ThorbenH/BarbelMotionTracker/3D-Files/Lid.stl

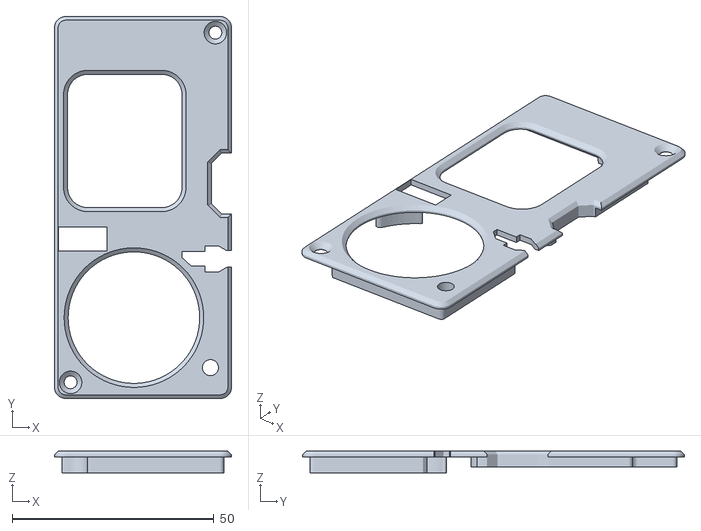
[picture p1: CAD file, 2024-10-22]
3D-Files/Lid.stl
43.9 x 94.7 x 5.40
