ThorbenH/BarbelMotionTracker/3D-Files/ScreenBackSupport.stl

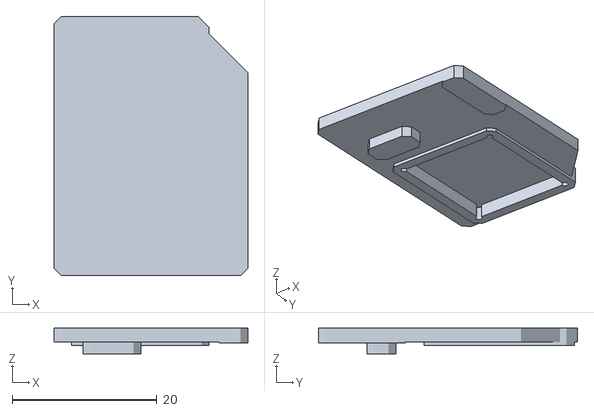
[picture p2: CAD file, 2024-10-22]
3D-Files/ScreenBackSupport.stl
26.8 x 35.8 x 3.55
