ThorbenH/BarbelMotionTracker/3D-Files/Case.stl

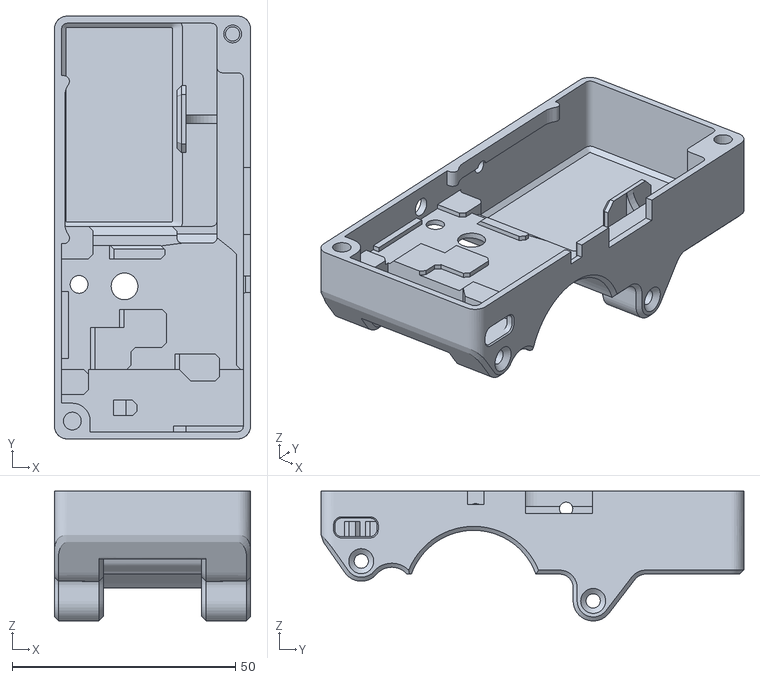
[picture p3: CAD file, 2024-10-22]
3D-Files/Case.stl
43.9 x 94.7 x 29.1
