ThorbenH/BarbelMotionTracker/3D-Files/EncoderSpacer.stl

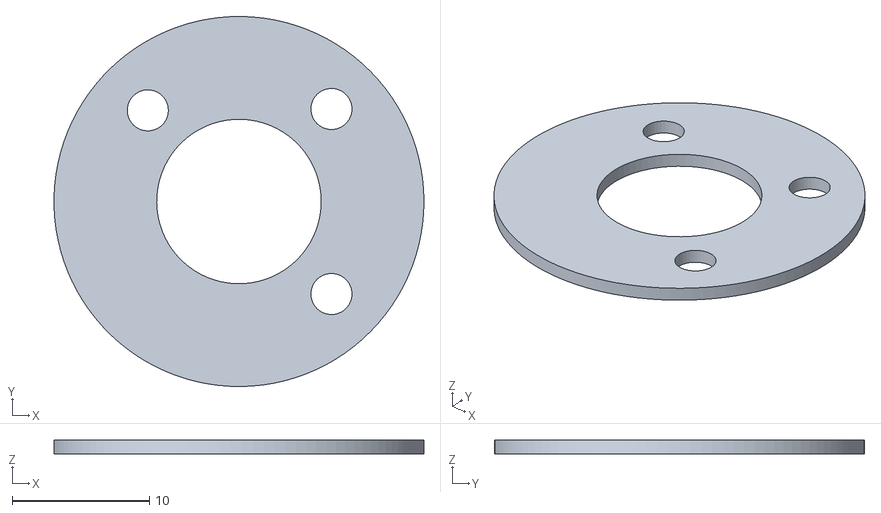
[picture p4: CAD file, 2024-10-22]
3D-Files/EncoderSpacer.stl
27.0 x 27.0 x 1.00
