ThorbenH/BarbelMotionTracker/3D-Files/LidClosedSD.stl

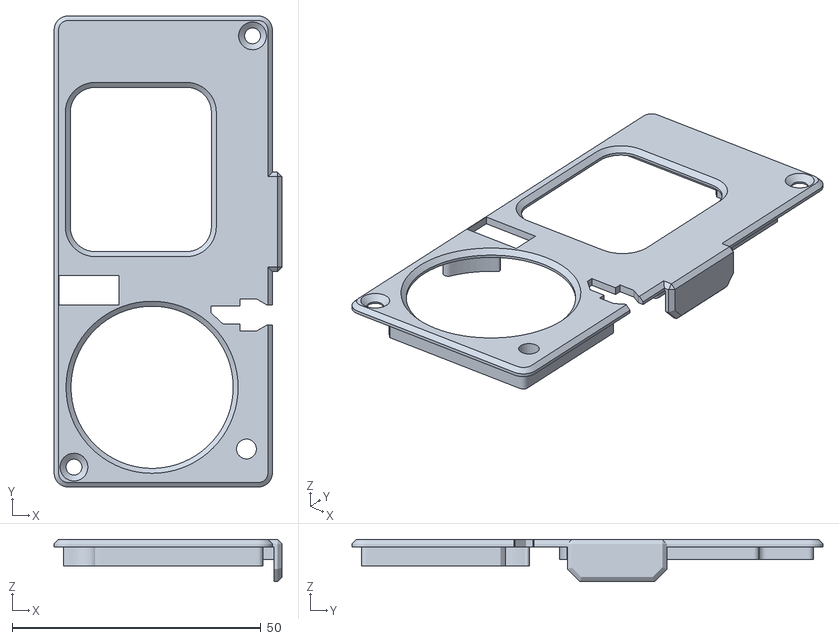
[picture p5: CAD file, 2024-10-22]
3D-Files/LidClosedSD.stl
45.8 x 94.7 x 8.50
