ThorbenH/BarbelMotionTracker/PCB_Design/BarbelMotionTracker-V1.kicad_pcb

## KiCad design PCB_Design/BarbelMotionTracker-V1.kicad_pcb (2024-09-08)

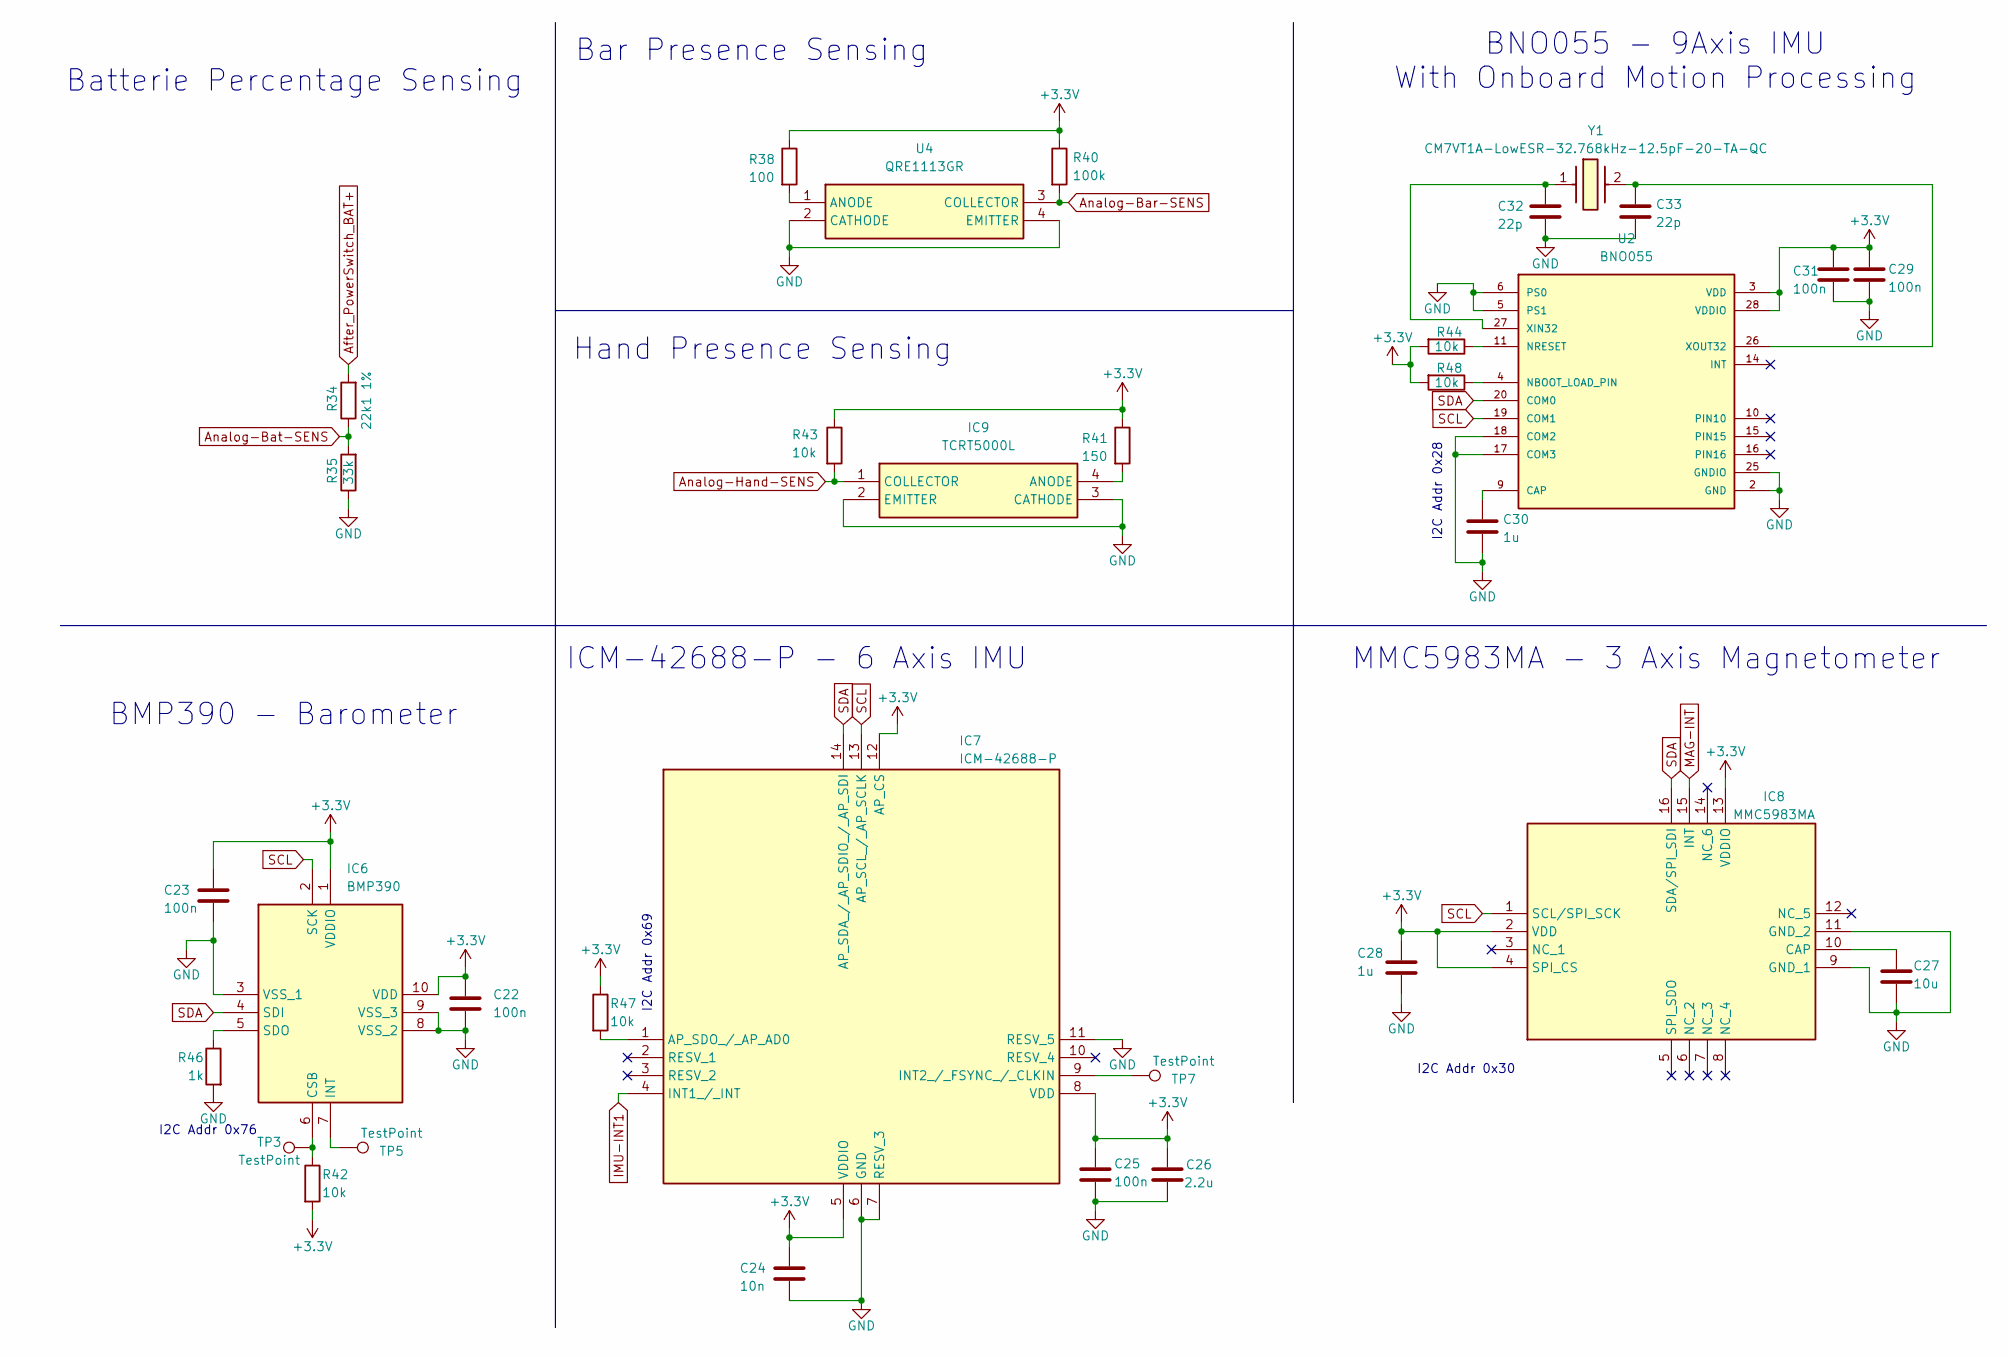
[picture p6: schematic sensors.kicad_sch, Barbel Motion Tracker]

Parts:
C22, C23, C25, C29, C31: 100n; C_0603_1608Metric
C24: 10n; C_0603_1608Metric
C26: 2.2u; C_0603_1608Metric
C27: 10u; C_0805_2012Metric
C28, C30: 1u; C_0603_1608Metric
C32, C33: 22p; C_0402_1005Metric
IC6: BMP390; Mouser Part Number 262-BMP390
IC7: ICM-42688-P; IIM42352; Mouser Part Number 410-ICM-42688-P
IC8: MMC5983MA; Mouser Part Number 438-MMC5983MA
IC9: TCRT5000L; Mouser Part Number 782-TCRT5000L
R34: 22k1 1%; R_0603_1608Metric
R35: 33k; R_0603_1608Metric
R38: 100; R_1206_3216Metric
R40: 100k; R_0603_1608Metric
R41: 150; R_1206_3216Metric
R42, R43, R44, R47, R48: 10k; R_0603_1608Metric
R46: 1k; R_0603_1608Metric
TP3, TP5, TP7: TestPoint; TestPoint_Pad_D1.0mm
U2: BNO055; LGA28R50P4X10_380X520X100
U4: QRE1113GR; Mouser Part Number 512-QRE1113GR
Y1: CM7VT1A-LowESR-32.768kHz-12.5pF-20-TA-QC; CM7V32768TBQA020; Mouser Part Number 428-202740-MG01

Connections:
+3.3V: C22.1, C23.1, C24.1, C25.1, C26.1, C28.1, C29.1, C31.1, IC6.1 (VDDIO), IC6.10 (VDD), IC7.5 (VDDIO), IC7.8 (VDD), IC7.12 (AP_CS), IC8.2 (VDD), IC8.4 (SPI_CS), IC8.13 (VDDIO), R38.1, R40.1, R41.1, R42.2, R43.1, R44.2, R47.1, R48.2, U2.3 (VDD), U2.28 (VDDIO); also elsewhere on the board
After_PowerSwitch_BAT+: R34.2; also elsewhere on the board
Analog-Bar-SENS: R40.2, U4.3 (COLLECTOR); also elsewhere on the board
Analog-Bat-SENS: R34.1, R35.2; also elsewhere on the board
Analog-Hand-SENS: IC9.1 (COLLECTOR), R43.2; also elsewhere on the board
GND: C22.2, C23.2, C24.2, C25.2, C26.2, C27.2, C28.2, C29.2, C30.2, C31.2, C32.2, C33.2, IC6.3 (VSS_1), IC6.8 (VSS_2), IC6.9 (VSS_3), IC7.6 (GND), IC7.7 (RESV_3), IC7.11 (RESV_5), IC8.9 (GND_1), IC8.11 (GND_2), IC9.2 (EMITTER), IC9.3 (CATHODE), R35.1, R46.2, U2.2 (GND), U2.5 (PS1), U2.6 (PS0), U2.17 (COM3), U2.18 (COM2), U2.25 (GNDIO), U4.2 (CATHODE), U4.4 (EMITTER); also elsewhere on the board
IMU-INT1: IC7.4 (INT1_/_INT); also elsewhere on the board
MAG-INT: IC8.15 (INT); also elsewhere on the board
unnamed: IC6.6 (CSB), R42.1, TP3.1
unnamed: IC6.7 (INT), TP5.1
unnamed: IC6.5 (SDO), R46.1
unnamed: IC7.1 (AP_SDO_/_AP_AD0), R47.2
unnamed: IC7.9 (INT2_/_FSYNC_/_CLKIN), TP7.1
unnamed: C27.1, IC8.10 (CAP)
unnamed: IC9.4 (ANODE), R41.2
unnamed: C30.1, U2.9 (CAP)
unnamed: R48.1, U2.4 (NBOOT_LOAD_PIN)
unnamed: R44.1, U2.11 (NRESET)
unnamed: C32.1, U2.27 (XIN32), Y1.1
unnamed: C33.1, U2.26 (XOUT32), Y1.2
unnamed: R38.2, U4.1 (ANODE)
SCL: IC6.2 (SCK), IC7.13 (AP_SCL_/_AP_SCLK), IC8.1 (SCL/SPI_SCK), U2.19 (COM1); also elsewhere on the board
SDA: IC6.4 (SDI), IC7.14 (AP_SDA_/_AP_SDIO_/_AP_SDI), IC8.16 (SDA/SPI_SDI), U2.20 (COM0); also elsewhere on the board

Notes on the sheet:
BMP390 - Barometer
I2C Addr 0x28
Batterie Percentage Sensing
ICM-42688-P - 6 Axis IMU
BNO055 - 9Axis IMU With Onboard Motion Processing
MMC5983MA - 3 Axis Magnetometer
Hand Presence Sensing
I2C Addr 0x69
I2C Addr 0x76
Bar Presence Sensing
I2C Addr 0x30

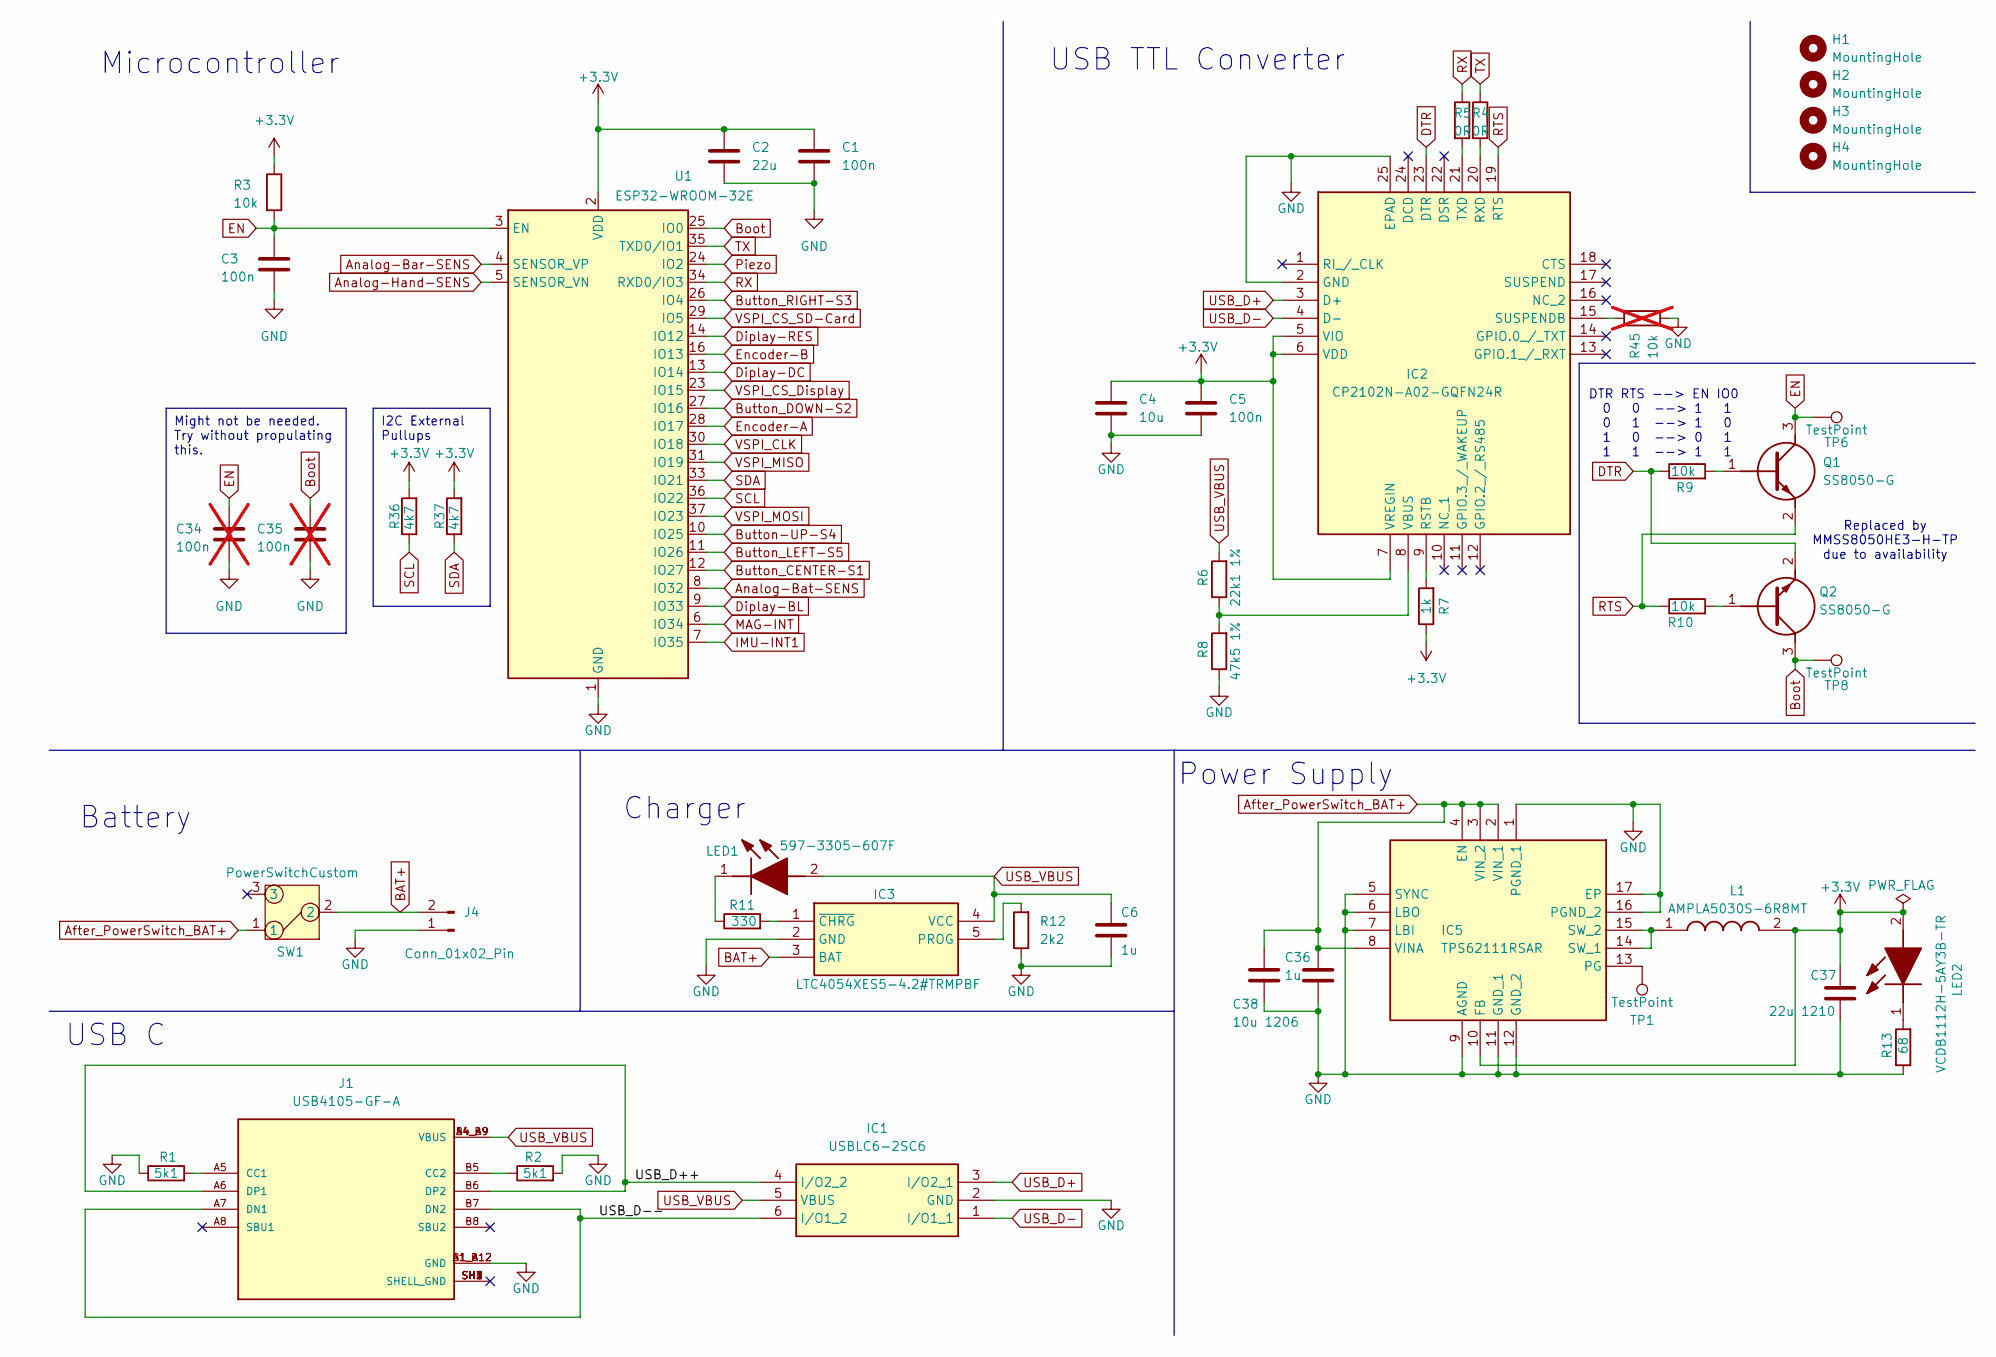
[picture p7: schematic microcontroller.kicad_sch, Barbel Motion Tracker]

Parts:
C1, C3, C5: 100n; C_0603_1608Metric
C2: 22u; C_0805_2012Metric
C4: 10u; C_0805_2012Metric
C6, C36: 1u; C_0603_1608Metric
C34, C35: 100n; C_0603_1608Metric; not fitted
C37: 22u 1210; C_1210_3225Metric
C38: 10u 1206; C_1206_3216Metric
H1, H2, H3, H4: MountingHole; MountingHole_2.2mm_M2
IC1: USBLC6-2SC6; SOT95P280X145-6N; Mouser Part Number 511-USBLC6-2SC6
IC2: CP2102N-A02-GQFN24R; QFN50P400X400X80-25N-D; Mouser Part Number 634-CP2102NA02QFN24R
IC3: LTC4054XES5-4.2#TRMPBF; SOT95P280X100-5N; Mouser Part Number 584-C4054XES54.2TMPF
IC5: TPS62111RSAR; QFN65P400X400X100-17N; Mouser Part Number 595-TPS62111RSAR
J1: USB4105-GF-A; GCT_USB4105-GF-A; PARTREV B3
J4: Conn_01x02_Pin; JST_PH_S2B-PH-K_1x02_P2.00mm_Horizontal
L1: AMPLA5030S-6R8MT; INDPM5752X300N; Manufacturer_Part_Number AMPLA5030S-6R8MT
LED1: 597-3305-607F; LEDC2012X70N; Mouser Part Number 645-597-3305-607F
LED2: VCDB1112H-5AY3B-TR; LEDC2012X90N; Mouser Part Number 327-VCDB1112H5AY3BTR
Q1, Q2: SS8050-G; SOT95P240X115-3N; Mouser Part Number 750-SS8050-G
R1, R2: 5k1; R_0603_1608Metric
R3, R9, R10: 10k; R_0603_1608Metric
R4, R5: 0R; R_0603_1608Metric
R6: 22k1 1%; R_0603_1608Metric
R7: 1k; R_0603_1608Metric
R8: 47k5 1%; R_0603_1608Metric
R11: 330; R_0603_1608Metric
R12: 2k2; R_0603_1608Metric
R13: 68; R_0603_1608Metric
R36, R37: 4k7; R_0603_1608Metric
R45: 10k; R_0603_1608Metric; not fitted
SW1: PowerSwitchCustom
TP1, TP6, TP8: TestPoint; TestPoint_Pad_D1.0mm
U1: ESP32-WROOM-32E

Connections:
+3.3V: C1.1, C2.1, C4.1, C5.1, C37.1, IC2.5 (VIO), IC2.6 (VDD), IC2.7 (VREGIN), IC5.10 (FB), L1.2, LED2.2 (A), R3.1, R7.1, R36.2, R37.2, U1.2 (VDD); also elsewhere on the board
/microcontroller/USB_D++: IC1.4 (I/O2_2), J1.A6 (DP1), J1.B6 (DP2)
/microcontroller/USB_D--: IC1.6 (I/O1_2), J1.A7 (DN1), J1.B7 (DN2)
After_PowerSwitch_BAT+: C36.1, C38.1, IC5.2 (VIN_1), IC5.3 (VIN_2), IC5.4 (EN), IC5.8 (VINA), SW1.1; also elsewhere on the board
Analog-Bar-SENS: U1.4 (SENSOR_VP); also elsewhere on the board
Analog-Bat-SENS: U1.8 (IO32); also elsewhere on the board
Analog-Hand-SENS: U1.5 (SENSOR_VN); also elsewhere on the board
BAT+: IC3.3 (BAT), J4.2, SW1.2
Boot: C35.1, Q2.3 (C), TP8.1, U1.25 (IO0)
Button-UP-S4: U1.10 (IO25); also elsewhere on the board
Button_CENTER-S1: U1.12 (IO27); also elsewhere on the board
Button_DOWN-S2: U1.27 (IO16); also elsewhere on the board
Button_LEFT-S5: U1.11 (IO26); also elsewhere on the board
Button_RIGHT-S3: U1.26 (IO4); also elsewhere on the board
DTR: IC2.23 (DTR), Q2.2 (E), R9.1
Diplay-BL: U1.9 (IO33); also elsewhere on the board
Diplay-DC: U1.13 (IO14); also elsewhere on the board
Diplay-RES: U1.14 (IO12); also elsewhere on the board
EN: C3.1, C34.1, Q1.3 (C), R3.2, TP6.1, U1.3 (EN)
Encoder-A: U1.28 (IO17); also elsewhere on the board
Encoder-B: U1.16 (IO13); also elsewhere on the board
GND: C1.2, C2.2, C3.2, C4.2, C5.2, C6.2, C34.2, C35.2, C36.2, C37.2, C38.2, IC1.2 (GND), IC2.2 (GND), IC2.25 (EPAD), IC3.2 (GND), IC5.1 (PGND_1), IC5.5 (SYNC), IC5.6 (LBO), IC5.7 (LBI), IC5.9 (AGND), IC5.11 (GND_1), IC5.12 (GND_2), IC5.16 (PGND_2), IC5.17 (EP), J1.A1_B12 (GND), J1.B1_A12 (GND), J4.1, R1.1, R2.2, R8.1, R12.1, R13.1, R45.2, U1.1 (GND), U1.15 (GND), U1.38 (GND), U1.39 (GND); also elsewhere on the board
IMU-INT1: U1.7 (IO35); also elsewhere on the board
MAG-INT: U1.6 (IO34); also elsewhere on the board
unnamed: IC2.9 (RSTB), R7.2
unnamed: IC2.20 (RXD), R4.2
unnamed: IC2.15 (SUSPENDB), R45.1
unnamed: IC2.21 (TXD), R5.2
unnamed: IC2.8 (VBUS), R6.1, R8.2
unnamed: IC3.5 (PROG), R12.2
unnamed: IC3.1 (~CHRG), R11.2
unnamed: IC5.13 (PG), TP1.1
unnamed: IC5.14 (SW_1), IC5.15 (SW_2), L1.1
unnamed: J1.A5 (CC1), R1.2
unnamed: J1.B5 (CC2), R2.1
unnamed: LED1.1 (K), R11.1
unnamed: LED2.1 (K), R13.2
unnamed: Q1.1 (B), R9.2
unnamed: Q2.1 (B), R10.2
Piezo: U1.24 (IO2); also elsewhere on the board
RTS: IC2.19 (RTS), Q1.2 (E), R10.1
RX: R5.1, U1.34 (RXD0/IO3)
SCL: R36.1, U1.36 (IO22); also elsewhere on the board
SDA: R37.1, U1.33 (IO21); also elsewhere on the board
TX: R4.1, U1.35 (TXD0/IO1)
USB_D+: IC1.3 (I/O2_1), IC2.3 (D+)
USB_D-: IC1.1 (I/O1_1), IC2.4 (D-)
USB_VBUS: C6.1, IC1.5 (VBUS), IC3.4 (VCC), J1.A4_B9 (VBUS), J1.B4_A9 (VBUS), LED1.2 (A), R6.2
VSPI_CLK: U1.30 (IO18); also elsewhere on the board
VSPI_CS_Display: U1.23 (IO15); also elsewhere on the board
VSPI_CS_SD-Card: U1.29 (IO5); also elsewhere on the board
VSPI_MISO: U1.31 (IO19); also elsewhere on the board
VSPI_MOSI: U1.37 (IO23); also elsewhere on the board

Notes on the sheet:
I2C External Pullups
Might not be needed. Try without propulating this.
DTR RTS --> EN IO0 0 0 --> 1 1 0 1 --> 1 0 1 0 --> 0 1 1 1 --> 1 1
USB C
Charger
USB TTL Converter
Replaced by MMSS8050HE3-H-TP due to availability
Battery
Microcontroller
Power Supply

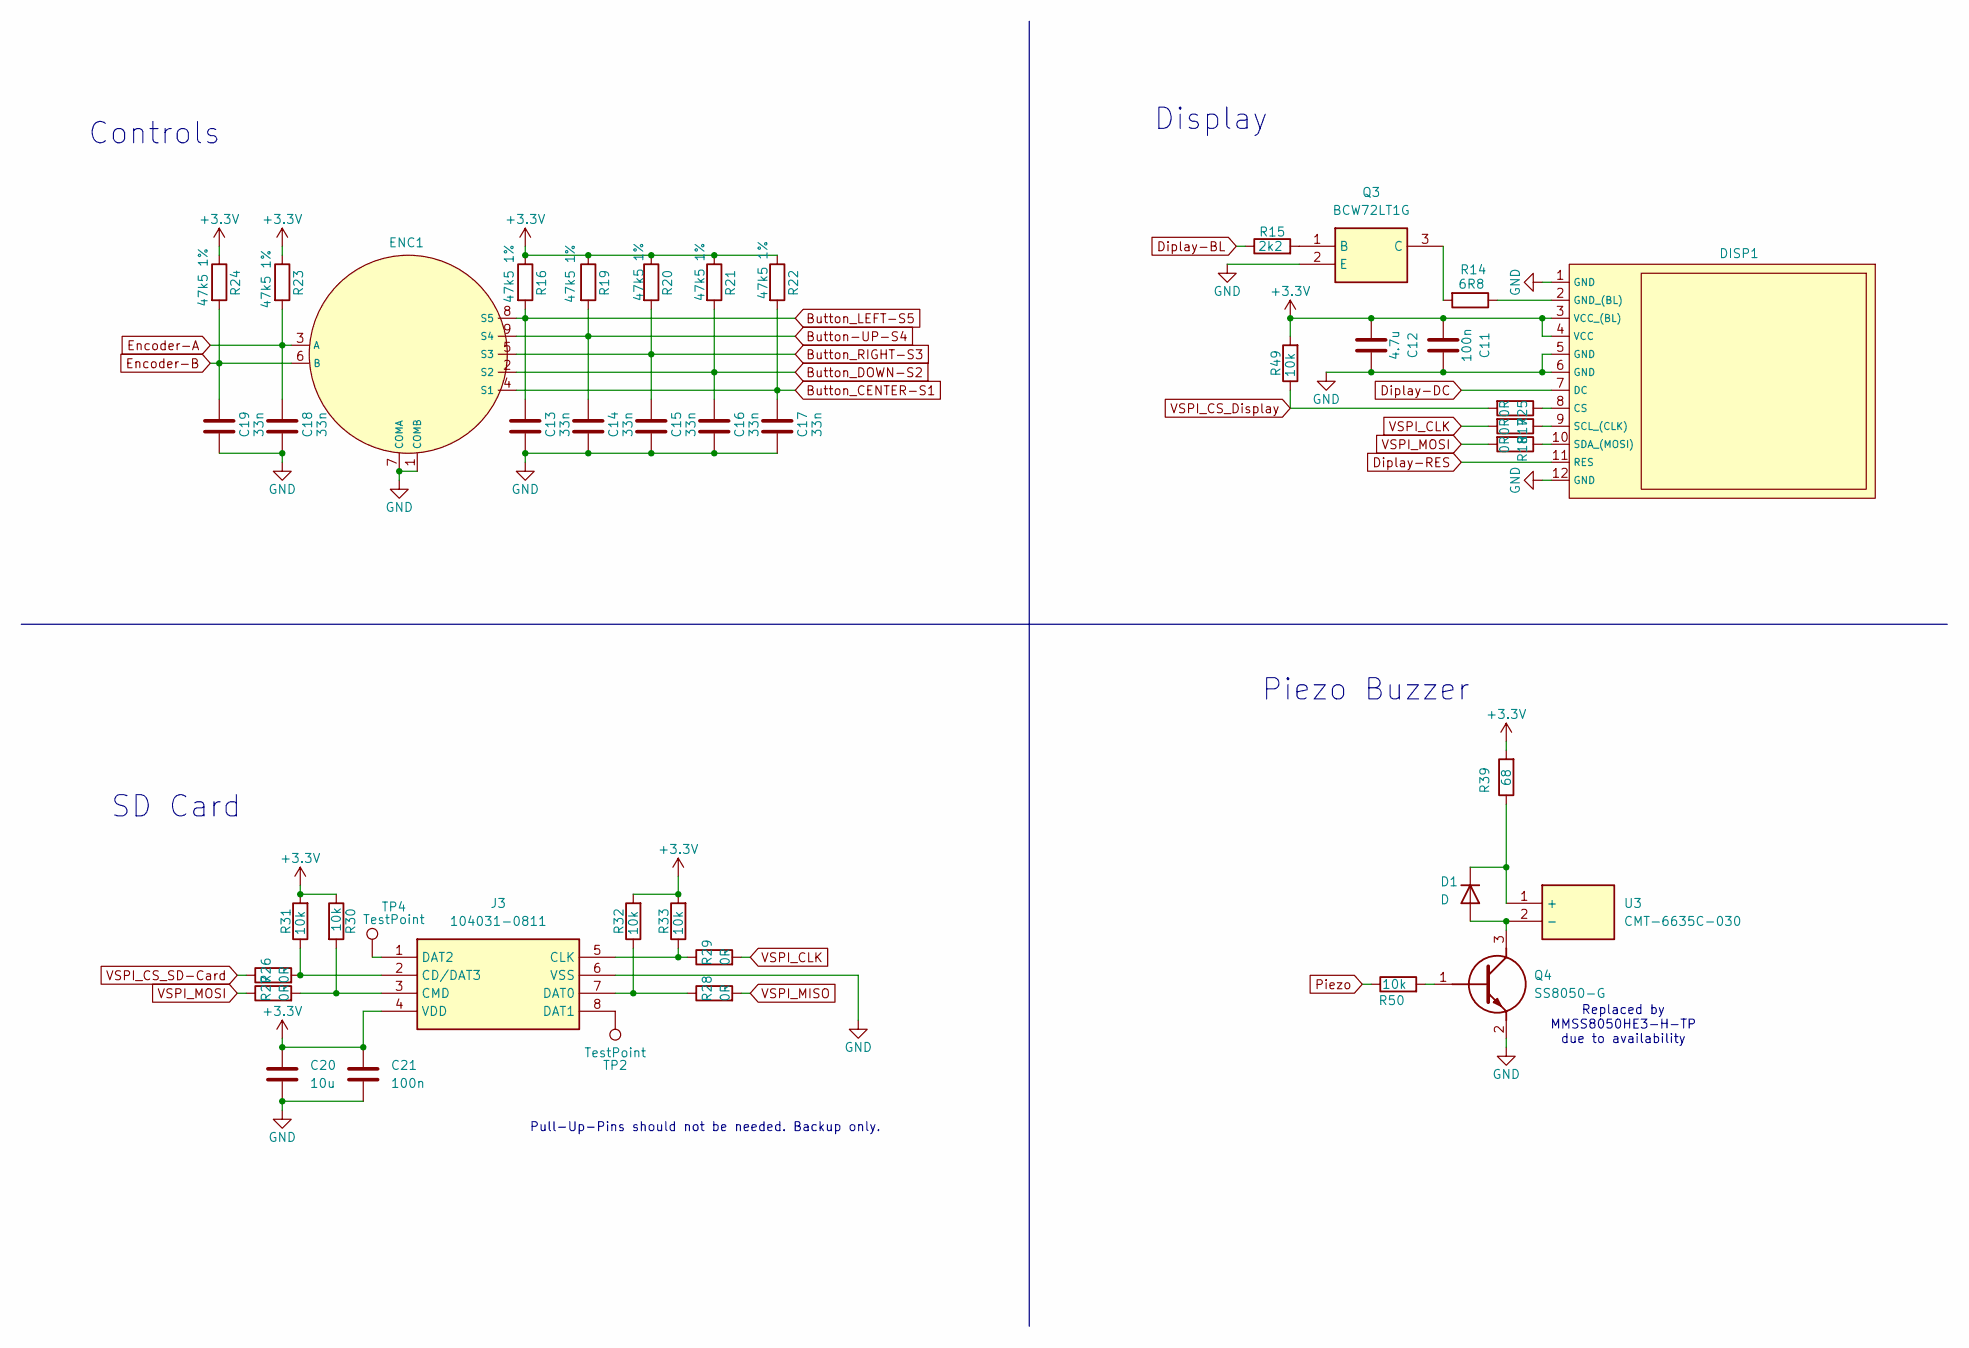
[picture p8: schematic display_control_sdcard.kicad_sch, Barbel Motion Tracker]

Parts:
C11, C21: 100n; C_0603_1608Metric
C12: 4.7u; C_0603_1608Metric
C13, C14, C15, C16, C17, C18, C19: 33n; C_0603_1608Metric
C20: 10u; C_0805_2012Metric
D1: D; D_0805_2012Metric
DISP1: Display_ST7789V2
ENC1: ZippyRotaryEncoder_ANO
J3: 104031-0811; 1040310811; Mouser Part Number 538-104031-0811
Q3: BCW72LT1G; SOT96P237X111-3N; Mouser Part Number 863-BCW72LT1G
Q4: SS8050-G; SOT95P240X115-3N; Mouser Part Number 750-SS8050-G
R14: 6R8; R_1206_3216Metric
R15: 2k2; R_0603_1608Metric
R16, R19, R20, R21, R22, R23, R24: 47k5 1%; R_0603_1608Metric
R17, R18, R25, R26, R27, R28, R29: 0R; R_0603_1608Metric
R30, R31, R32, R33, R49, R50: 10k; R_0603_1608Metric
R39: 68; R_0603_1608Metric
TP2, TP4: TestPoint; TestPoint_Pad_D1.0mm
U3: CMT-6635C-030; CMT6635C030; Mouser Part Number 490-CMT-6635C-030

Connections:
+3.3V: C11.1, C12.1, C20.1, C21.1, DISP1.3 (VCC_(BL)), DISP1.4 (VCC), J3.4 (VDD), R16.1, R19.1, R20.1, R21.1, R22.1, R23.1, R24.1, R30.1, R31.2, R32.2, R33.2, R39.2, R49.2; also elsewhere on the board
Button-UP-S4: C14.2, ENC1.9 (S4), R19.2; also elsewhere on the board
Button_CENTER-S1: C17.2, ENC1.4 (S1), R22.2; also elsewhere on the board
Button_DOWN-S2: C16.2, ENC1.2 (S2), R21.2; also elsewhere on the board
Button_LEFT-S5: C13.2, ENC1.8 (S5), R16.2; also elsewhere on the board
Button_RIGHT-S3: C15.2, ENC1.5 (S3), R20.2; also elsewhere on the board
Diplay-BL: R15.1; also elsewhere on the board
Diplay-DC: DISP1.7 (DC); also elsewhere on the board
Diplay-RES: DISP1.11 (RES); also elsewhere on the board
Encoder-A: C18.2, ENC1.3 (A), R23.2; also elsewhere on the board
Encoder-B: C19.2, ENC1.6 (B), R24.2; also elsewhere on the board
GND: C11.2, C12.2, C13.1, C14.1, C15.1, C16.1, C17.1, C18.1, C19.1, C20.2, C21.2, DISP1.1 (GND), DISP1.5 (GND), DISP1.6 (GND), DISP1.12 (GND), ENC1.1 (COMB), ENC1.7 (COMA), J3.6 (VSS), Q3.2 (E), Q4.2 (E); also elsewhere on the board
unnamed: D1.2 (A), Q4.3 (C), U3.2 (-)
unnamed: D1.1 (K), R39.1, U3.1 (+)
unnamed: DISP1.8 (CS), R25.1
unnamed: DISP1.2 (GND_(BL)), R14.1
unnamed: DISP1.9 (SCL_(CLK)), R17.1
unnamed: DISP1.10 (SDA_(MOSI)), R18.1
unnamed: J3.2 (CD/DAT3), R26.2, R31.1
unnamed: J3.5 (CLK), R29.1, R33.1
unnamed: J3.3 (CMD), R27.2, R30.2
unnamed: J3.7 (DAT0), R28.1, R32.1
unnamed: J3.8 (DAT1), TP2.1
unnamed: J3.1 (DAT2), TP4.1
unnamed: Q3.1 (B), R15.2
unnamed: Q3.3 (C), R14.2
unnamed: Q4.1 (B), R50.2
Piezo: R50.1; also elsewhere on the board
VSPI_CLK: R17.2, R29.2; also elsewhere on the board
VSPI_CS_Display: R25.2, R49.1; also elsewhere on the board
VSPI_CS_SD-Card: R26.1; also elsewhere on the board
VSPI_MISO: R28.2; also elsewhere on the board
VSPI_MOSI: R18.2, R27.1; also elsewhere on the board

Notes on the sheet:
Pull-Up-Pins should not be needed. Backup only.
Piezo Buzzer
Display
Controls
SD Card
Replaced by MMSS8050HE3-H-TP due to availability

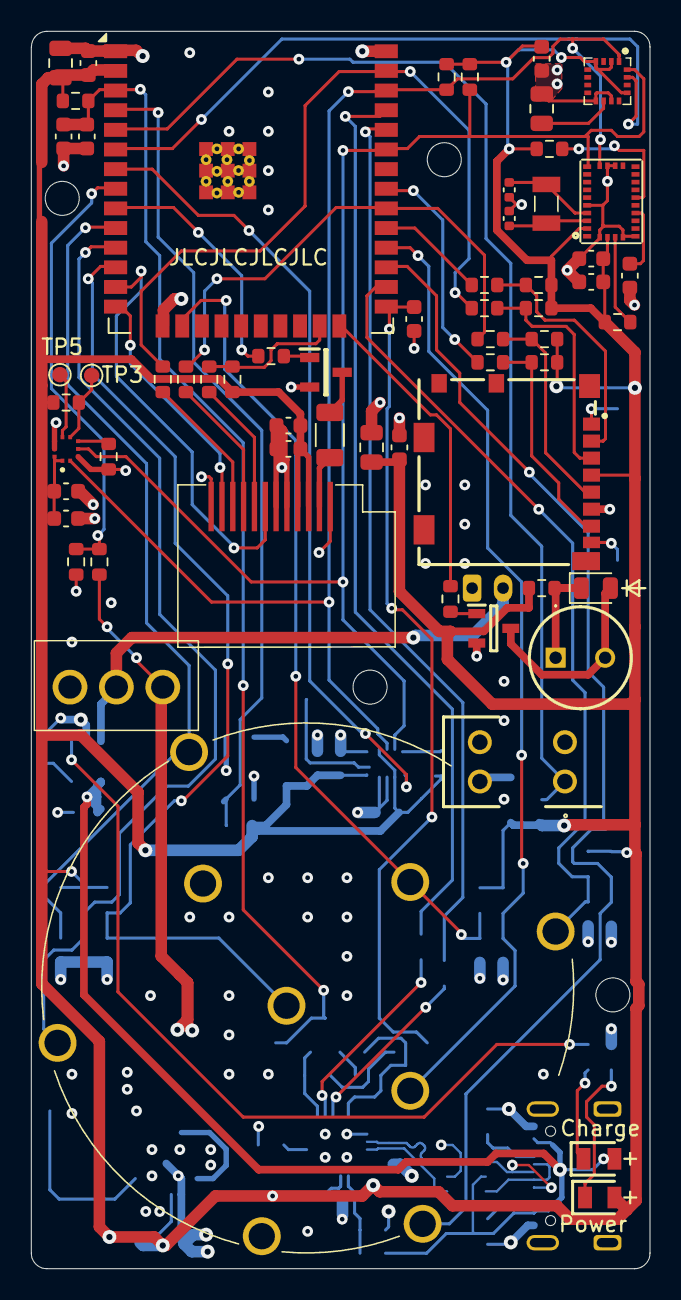
[picture p9: board BarbelMotionTracker-V1.kicad_pcb from above]

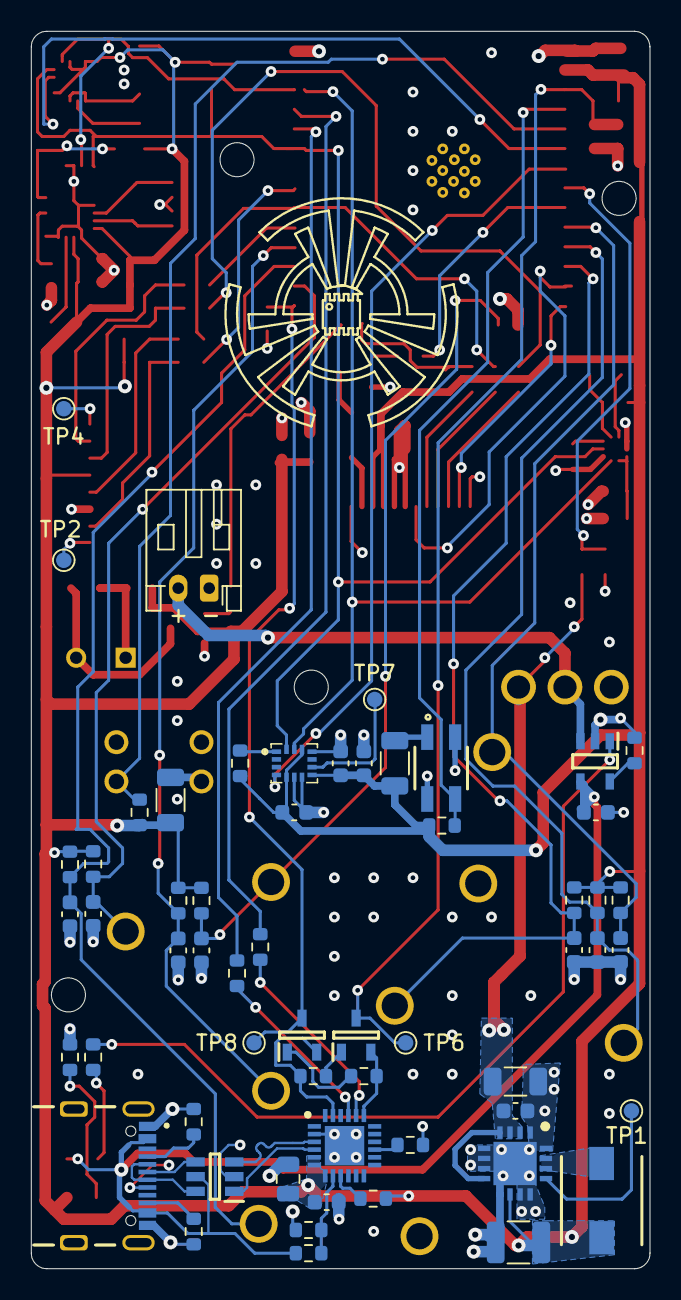
[picture p10: board BarbelMotionTracker-V1.kicad_pcb from below]

Board: 4 copper layers, 40.0 x 80.0 mm, 123 parts (58 on the bottom side), 81 nets.
