ThorbenH/BarbelMotionTracker/Software-BarbelMotionTracker/src/pins.h

#pragma once

static const int BOOT_PIN            = 0;
static const int TX_PIN              = 1;
static const int RX_PIN              = 3;
static const int SDA_PIN             = 21;
static const int SCL_PIN             = 22;



static const int PIEZO               = 2;
static const int BUTTON_CENTER_S1    = 27;
static const int BUTTON_DOWN_S2      = 16;
static const int BUTTON_RIGHT_S3     = 4;
static const int BUTTON_UP_S4        = 25;
static const int BUTTON_LEFT_S5      = 26;
static const int ENCODER_A           = 17;
static const int ENCODER_B           = 13;



static const int VSPI_CLK            = 18;
static const int VSPI_MISO           = 19;
static const int VSPI_MOSI           = 23;

static const int DISPLAY_RES         = 12;
static const int DISPLAY_DC          = 14;
static const int DISPLAY_BL          = 33;
static const int VSPI_CS_DISPLAY     = 15;

static const int VSPI_CS_SD_CARD     = 5;



static const int MAG_INT             = 34;
static const int IMU_INT1            = 35;



static const int ANALOG_BAT_SENS     = 32;       
static const int ANALOG_BAR_SENS     = 36; //SENSOR_VP
static const int ANALOG_HAND_SENS    = 39; //SENSOR_VN
