ThorbenH/BarbelMotionTracker/(commit log)

2024-09-08 Added PCB Design files
    [BarbelMotionTracker-V1-B_Cu.gbr, BarbelMotionTracker-V1-B_Mask.gbr, BarbelMotionTracker-V1-B_Paste.gbr, BarbelMotionTracker-V1-B_Silkscreen.gbr, BarbelMotionTracker-V1-Edge_Cuts.gbr, BarbelMotionTracker-V1-F_Cu.gbr, BarbelMotionTracker-V1-F_Mask.gbr, BarbelMotionTracker-V1-F_Paste.gbr]
2024-10-22 Added code for device
    [Case.stl, EncoderSpacer.stl, Lid.stl, LidClosedSD.stl, ScreenBackSupport.stl]
2024-10-22 added calibration data gathering code
